explAIn-channel/bratan-robot/brain/ARCHITECTURE.md

> Журнал решений по ходу разработки (октябрь 2026). Где он расходится с кодом, прав код: например, связь с платой текстовая, навыки идут на 25 Гц, а нейросеть езды загружена, но колёсами не управляет.

# Братан 2 — архитектура

Новый проект вместо r284/r285 (06.10.2026, по указанию владельца: всё переписать
заново, качественно, максимально быстро; логика, данные и обученные модели — старые).
Старая версия остаётся на телефоне и плате для отката.

## Железо (измерено 06.10.2026)

| Узел | Факт | Вывод для архитектуры |
|---|---|---|
| Телефон SoC | Snapdragon 845: 4×A75 2,8 ГГц (cpu4-7) + 4×A55 1,77 ГГц (cpu0-3), 7,7 ГБ ОЗУ, 52 °C | тяжёлое на большие ядра, фон — на малые |
| Детектор YOLO26n-320 (ORT CPU) | 115 мс/1 поток, 70 мс/2, **50 мс/4 больших**, 134 мс/4 малых | 3 потока на cpu5-7: ~10 кадров/с |
| YOLO26n-640 / YOLOE-seg-640 | 183 / 292 мс на 4 больших | только для «рассмотреть», по запросу |
| Камера (id 1, фронт) | YUV 640×480, сенсор ≥15 кадр/с, **приложение режет до 4 кадр/с**, JPEG 45 КБ: выборка 9 мс + декод 6 мс | снять ограничение, отдавать свежий кадр сразу |
| Микрофон | 16 кГц моно, VOICE_RECOGNITION, NS+AEC | годится; поток вместо опроса |
| Плата | Allwinner A33 4×A7 1,2 ГГц, 512 МБ, почти простаивает | реальное время 50 Гц на плате |
| Связь телефон↔плата | Wi-Fi, RTT 3 мс, 50 Гц тело, пропуски до 0,1 с | ок; бинарный кадр вместо 1,2 КБ JSON |
| ИИ-мозг | OpenRouter deepseek-v4-flash: первый токен 0,9–1,5 с, ответ 1,2–2,6 с с keep-alive | одно постоянное соединение, короткие подсказки |
| GPT-Live | соединение 0,8 с через прокси, старт сессии ~1 с | соединение открывается в момент «Братан», параллельно с речью |
| Аккумулятор телефона | лимит 80 %, продолжение с 75 % (qcom restricted_charging) | сохранить |

## Процессы на телефоне

```
supervisor (bratan.main) ── шина (Unix-сокет, JSON-строки, pub/sub)
 ├─ body   cpu4, nice -10   связь с платой, поза, локализация, безопасность, навыки движения
 ├─ eyes   cpu5-7           камера, детектор, лица, трекер, геометрия
 ├─ voice  cpu0-1           микрофон, «Братан», GPT-Live, озвучка
 └─ mind   cpu2-3 (в supervisor)  жизнь, мозг (LLM), память, общение
```

Все процессы общаются только через шину. Тело не зависит от шины в вопросах
безопасности: защита от столкновений, сторож связи и остановка — внутри body.

## Ключевые решения по скорости

1. **Голос сразу в GPT-Live.** На «Братан» (первая ступень Vosk) сразу открывается
   сессия и в неё идёт звук с предзаписью; подтверждение имени (поток Vosk) идёт
   параллельно. Ответ GPT-Live проигрывается только после подтверждения; иначе
   сессия закрывается молча. Нет «конец речи → STT 1,2 с → соединение 2 с».
2. **Разговор — одно состояние.** Пока идёт живая сессия, мозг не управляет телом
   сам (только по просьбе человека) и не считает разговор оконченным.
3. **Мозг по событиям, без опроса раз в секунду.** События с шины сразу будят мозг;
   постоянное HTTPS-соединение к модели; подсказка ~2–3 тыс. токенов.
4. **Локализация на каждом скане.** Сопоставление скана с полем расстояний —
   Гаусс–Ньютон с аналитическим якобианом (≈2 мс), без процесса раз в 0,5 с.
5. **Управление 50 Гц, навыки 20 Гц** (было 10 Гц).
6. **Зрение без искусственных пауз.** Свежий кадр → детектор → событие на шине
   (≈100 мс от кадра до мозга вместо 0,4–2 с).

## Данные, переносимые из старой системы

карта квартиры и комнаты; поза базы и её эталонный скан; лица; альбом;
мысли/желания/планы/навыки/«кто я» мозга; характер; места; значимые предметы
(≥3 наблюдения); калибровки колёс, камеры, лидара; обученная нейросеть движения.

## Заученные проезды (07.10.2026, указание владельца)

Узкие двери, где поиск пути не справляется (кухня: Г-образный поворот с порогом, 8 см запаса на правильной линии), не ищутся, а проезжаются по линии, которую задал владелец, поставив робота руками (`body/passages.json`: старт x, y, курс; длина; скорость; отступ подхода; ворота-дверь). `Navigate` после каждого плана проверяет, проходит ли маршрут через ворота в направлении линии; если да — `passage_approach` (вложенный `Navigate` к точке на линии позади старта, без проездов), `passage_run` (0,24 м/с, курс линии минус 3 рад/м × боковое отклонение по позе карты, удержание курса платой), потом обычный план. Застрял 2,5 с — `passage_back`: задом по той же линии к началу и снова, до трёх раз; затем отказ `passage_blocked`, уже выехав из проёма.

## Мотивация (06.10.2026, по исследованию)

Владелец: «ничего не делать — странный выбор, у людей всегда есть мотивация». Анализ памяти мозга: целей, желаний, планов не было; будили только внешние события и таймер.

Источники и что взято:
- Kismet (Breazeal, MIT): потребность имеет комфортную зону — без дела уходит в «недостаток» (искать), при перегрузке в «избыток» (заняться другим). Взято: много разговоров за час — «скучаю по своим» утолено.
- Psi / MicroPsi (Dörner, Bach): самоистощающиеся потребности (энергия, принадлежность) и когнитивные (компетентность, определённость); подцели — части планов, ведущих к утолению. Взято: «уверенность» растёт от неудач тела и предлагает то, что точно получится.
- D2A (ICLR 2025, Wang и др.): у каждой потребности текущий и желаемый уровень (от характера), разрыв — мотив, уровни подаются модели словами; агент выбирает из кандидатов. Против ReAct/BabyAGI/LLMob 60–70 % побед по естественности и больше разнообразия. Взято: цели уровней от черт характера, словесные описания, кандидаты занятий у каждой потребности.
- Generative Agents (Park и др., 2023): поток памяти, рефлексия, план дня. Взято: рефлексия раз в 3 ч на базе («кто я», вывод), набросок своих планов, если их нет; сводка дня.
- Oudeyer (IAC): интересно новое, но достижимое. Взято: закрытые пути и непереведённые вещи не предлагаются.
- Anki Vector (открытый код): настроения Happy/Confident/Social затухают к дружелюбному «по умолчанию», «стимуляция» от людей/событий решает между исследованием и дремотой на зарядке; от чисто эмоционального поведения отказались в пользу явных переходов с кулдаунами. Взято: бодрость из недавних событий, настроение с добрым умолчанием, явные кулдауны (комната 10 мин, закрытый путь 10 мин), простой 2 мин → выбор занятия, ещё 2 мин → база.
- Sony aibo (патенты): независимые параметры желаний (упражнение, привязанность, аппетит, любопытство), обновляемые по времени и событиям, с взаимными корреляциями. LOVOT: потребность быть рядом с людьми как главный мотив.

Реализация: `bratan/mind/drives.py` (всё считается из архива и мира, переживает перезапуск), строки промпта «КАК Я СЕБЯ ЧУВСТВУЮ», «МОИ ПОТРЕБНОСТИ СЕЙЧАС», «МОИ ДОЛГИЕ ЦЕЛИ».

## Живость (07.10.2026, аудит по живым данным и мировому опыту)

Что делает робота живым, а не «умной колонкой» (Takayama/Ju HRI 2011, Vector, aibo, LOVOT, Miksik 2020):
- **Тело выражает внимание сразу, без модели.** Лицо и лампа: «слушаю» синий, «думаю» фиолетовый, «говорю»
  зелёный (голос, `source=voice`); мгновенные реакции на события (`source=reaction`): Таффа — радость, удар —
  удивление, перенос руками — удивление, касание кнопки — нежность. Глаза смотрят на человека (лицо первым) или
  Таффу по пеленгу камеры, в движении — в сторону поворота (`/gaze`, x>0 — влево от робота).
- **Привычки и привязанность считаются кодом**, модель только читает итог: где и когда кто бывает
  (по наблюдениям за 2 недели, время появления после перерыва), близость по разговорам и встречам (aibo/LOVOT:
  к тем, кто общается, робот привязывается сильнее). Это даёт поводы: «Сергей вечером обычно в спальне»,
  «Таффа чаще в коридоре» — и поиск идёт туда, а не вращением на месте.
- **Память честная и текущая.** Предмет, на место которого робот смотрит при свете и не видит, теряет доверие и
  забывается; посещения и освещённость комнат переживают перезапуск; планы имеют время и срок, желания — срок.
- **Речь редкая и по поводу.** Свои действия вслух не объявляются; мысли вслух — не чаще раза в 10 мин;
  одно приветствие Таффе за 20 мин; «помолчи» — инструмент `hush` на N минут; отказанная реплика не будит ум.
- **События устойчивы.** «Пришёл/ушёл» — после 2 кадров; потеря места — после 3 с; база — после 2 с без дребезга.

## Чувства и выражение (08.10.2026, второй аудит)

- **Слух** (`voice/sounds.py`, YAMNet 18 мс): лай, звонок, стук, хлопок двери, музыка, смех, плач, грохот и др.;
  испуг от резкого звука; привыкание; свой голос не слушает. Ум знает только то, что в «Слышу».
- **Двери** (`body/doors.py`): лидар видит проём — лучи вглубь соседней комнаты значит открыта, в полосу проёма значит
  закрыта; ум знает достижимые комнаты.
- **Движение вокруг** (`body/motion.py`): стоя, лидар замечает шаги сбоку и сзади — робот оборачивается.
- **Язык тела людей** (`eyes/gesture.py`): YOLO26n-pose (93 мс, до 5 раз/с, пока человек в кадре, камера тогда
  6 кадров/с — «внимательный» режим): помахали — радость, «привет», виляние; обе руки вверх — дрожь радости.
  FER+ (105 мс, раз в секунду, лицо от 56 пикселей): улыбка — улыбка в ответ молча; грустное лицо — ум может
  один раз мягко спросить. Топик `eyes.gesture {kind: wave|hands_up|smile|sad|surprise, who}`.
- **Выражение чувства целиком** (`life.express`): тело (`skills.Emote`: виляние, дрожь вперёд-назад, подпрыгивание,
  кивок, «нет», кружок, поклон — цели по одометрии), звук без слов как у R2-D2 (`voice/sfx.py`, уровень 0,032)
  и подсветка. Подсветка — LED-панель ELK-BLEDDM по BLE из приложения-лица: спокойное ожидание — ровный тёплый
  свет; чувство — встроенный режим панели на несколько секунд (`POST /mood-light/effect?name=&seconds=`, лицо 87+):
  rainbow (переливы 7 цветов), party (прыжки цветов), flash (белое мигание), warm/love/curious/calm (дыхание
  жёлтым/малиновым/голубым/синим), no (красное дыхание). Камера подтверждает мигание (разброс яркости кадров ×10).
- **Звуки** — редко и только для людей: вне базы, с человеком рядом, в игре или по просьбе; на базе — молча
  (владелец 08.10); никогда в одиночестве, никогда о внутреннем состоянии; одна пауза 30 с на рефлексы и ум.
- **Лицо в простое** — одно спокойное ожидание (моргает); чувства — только на настоящие события
  (`FACE_TRIGGERS`), коротким слоем reaction.
- **Встреча**: свой после 3+ часов разлуки — ум получает «ВСТРЕЧА» и дневник дома за это время
  (звонки, двери, Таффа, игры) и может одной фразой рассказать главное.
