explAIn-channel/bratan-robot/docs/media/consciousness.jpg

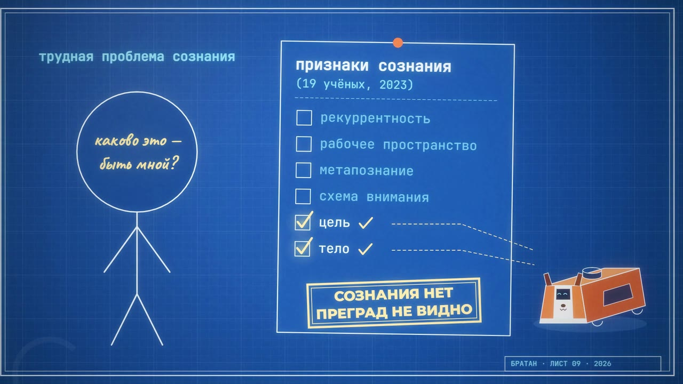
docs/media/consciousness.jpg
