explAIn-channel/bratan-robot/docs/media/face_close.jpg

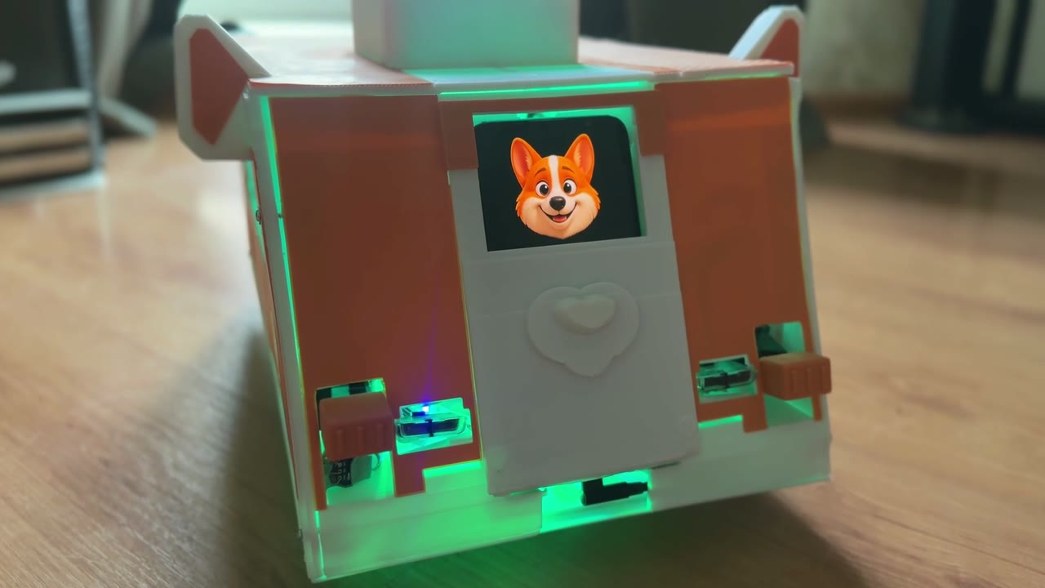
docs/media/face_close.jpg
