explAIn-channel/bratan-robot/docs/media/robot_eyes.jpg

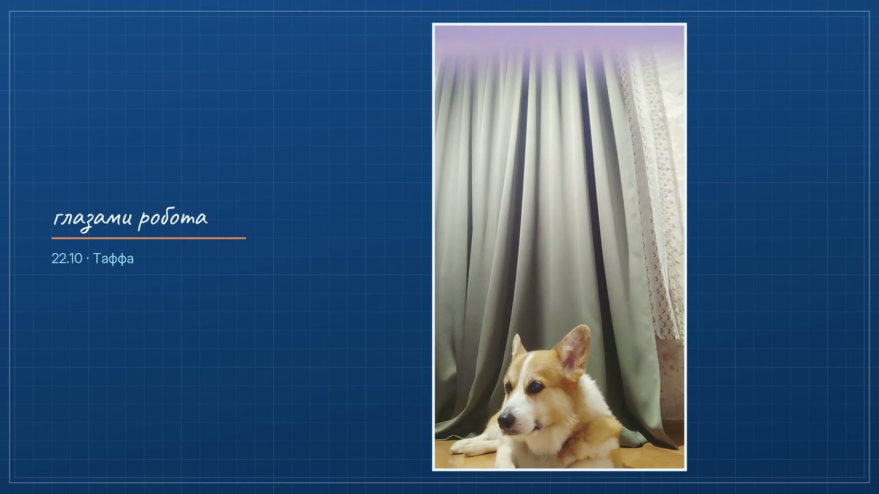
docs/media/robot_eyes.jpg
