explAIn-channel/bratan-robot/docs/media/two_brains.jpg

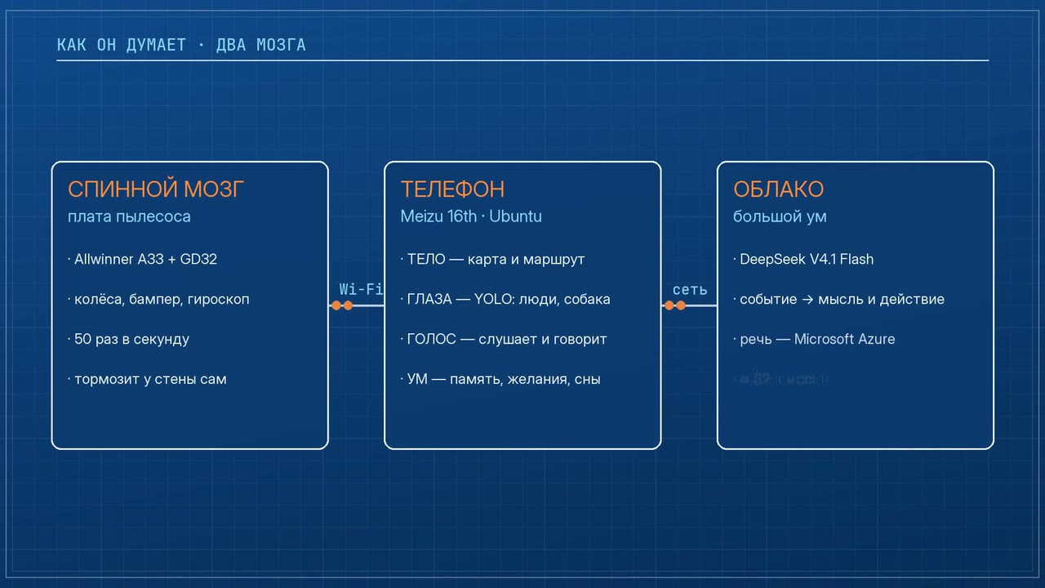
docs/media/two_brains.jpg
