explAIn-channel/bratan-robot/docs/media/weather.jpg

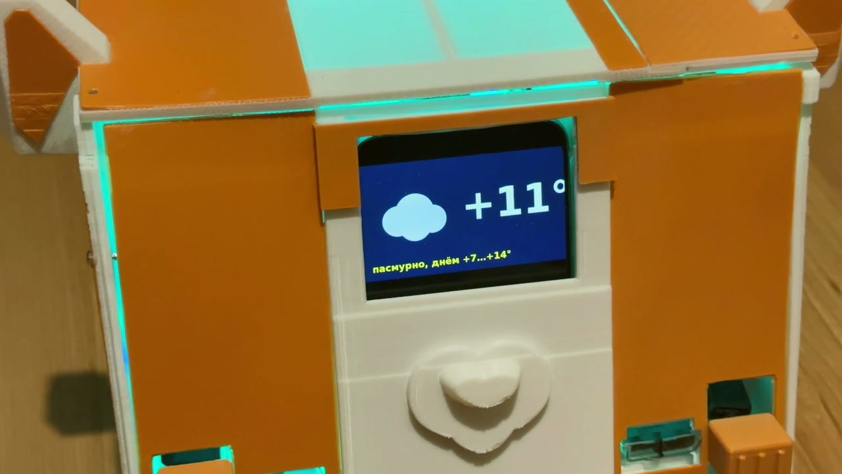
docs/media/weather.jpg
