explAIn-channel/bratan-robot/docs/media/why_vacuum.jpg

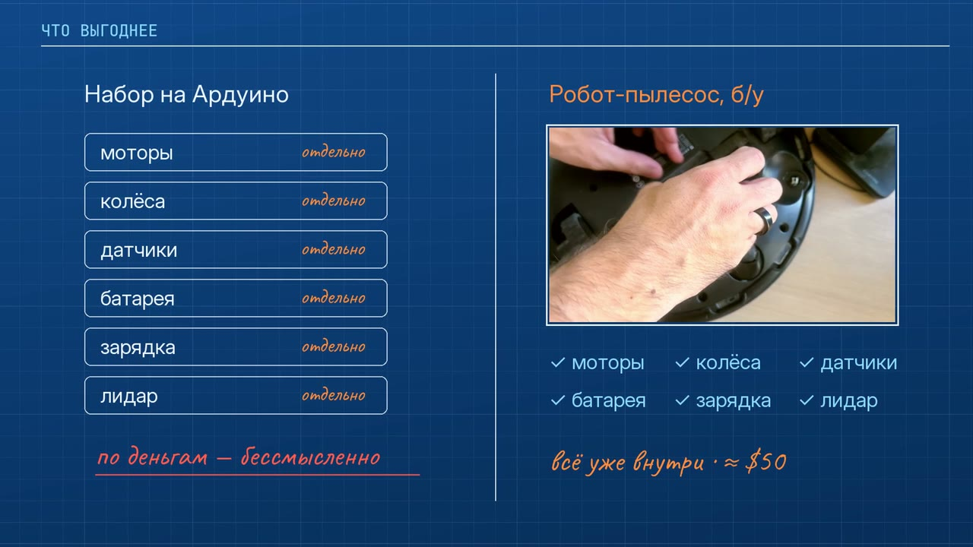
docs/media/why_vacuum.jpg
