explAIn-channel/bratan-robot/docs/media/with_taffy.jpg

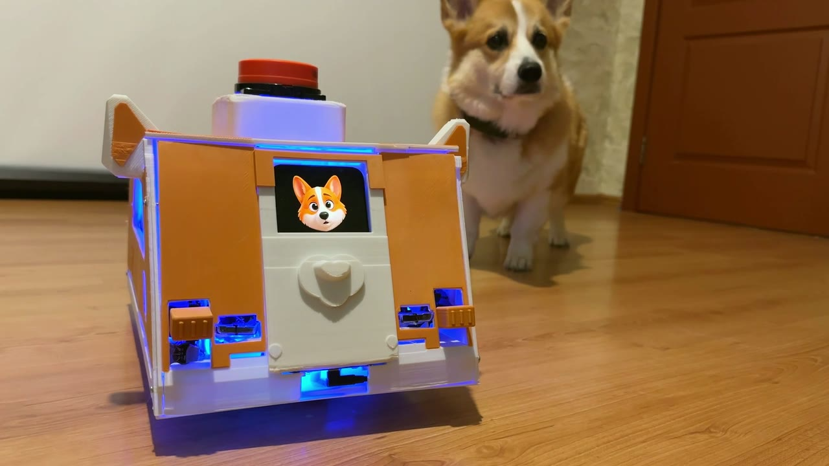
docs/media/with_taffy.jpg
