explAIn-channel/bratan-robot/docs/media/cost.jpg

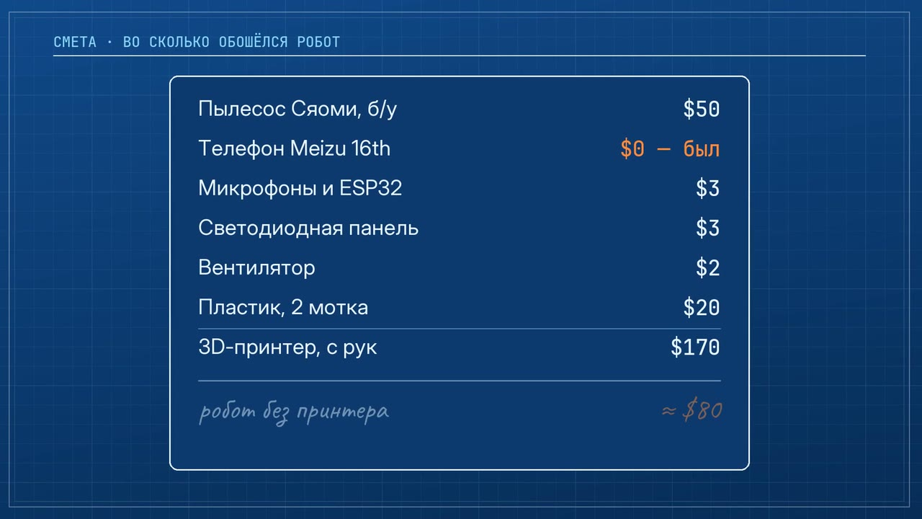
docs/media/cost.jpg
