explAIn-channel/bratan-robot/body/print/orange/08_roof_main_orange_inlay.stl

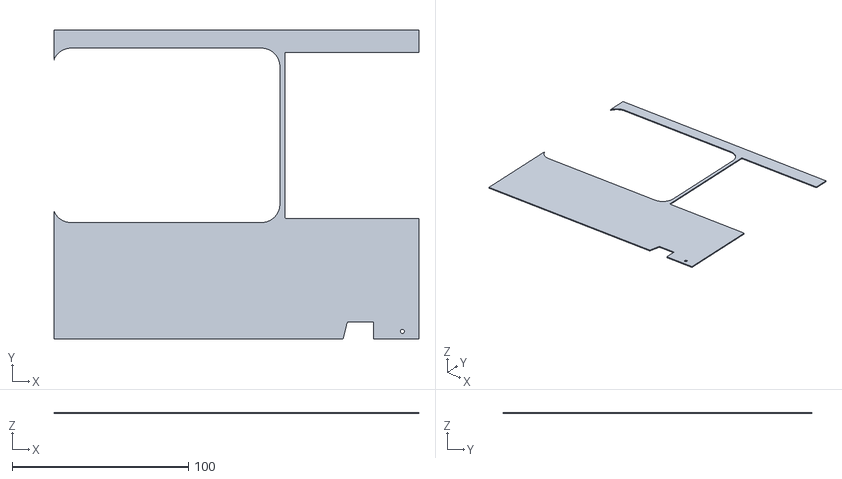
[picture p27: CAD file, 2026-10-23]
body/print/orange/08_roof_main_orange_inlay.stl
207.2 x 175.1 x 0.8
