explAIn-channel/bratan-robot/body/print/white/11_lid_front_main.stl

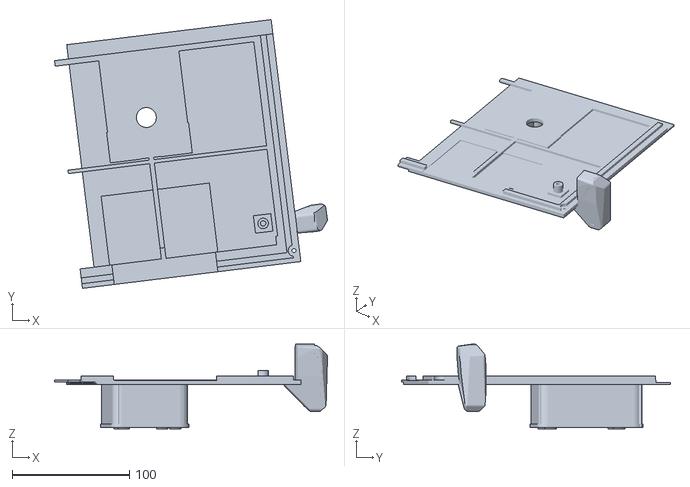
[picture p28: CAD file, 2026-10-23]
body/print/white/11_lid_front_main.stl
233.3 x 229.6 x 72.5
