explAIn-channel/bratan-robot/body/bratan_body_r5.stl

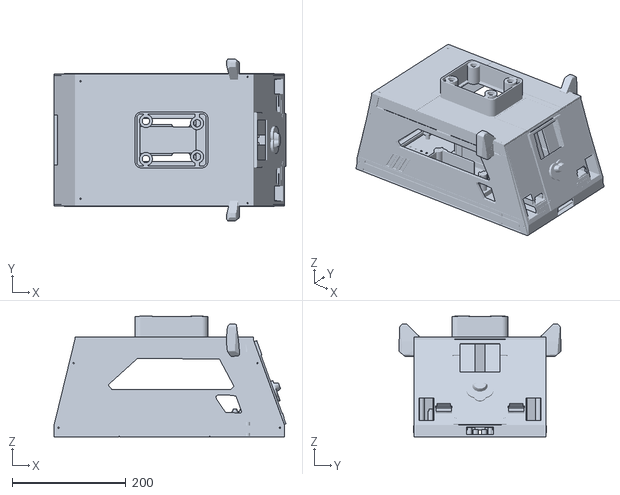
[picture p29: CAD file, 2026-10-23]
body/bratan_body_r5.stl
408.6 x 285.9 x 213.1
