explAIn-channel/bratan-robot/body/print/orange/09_roof_side_orange_inlay.stl

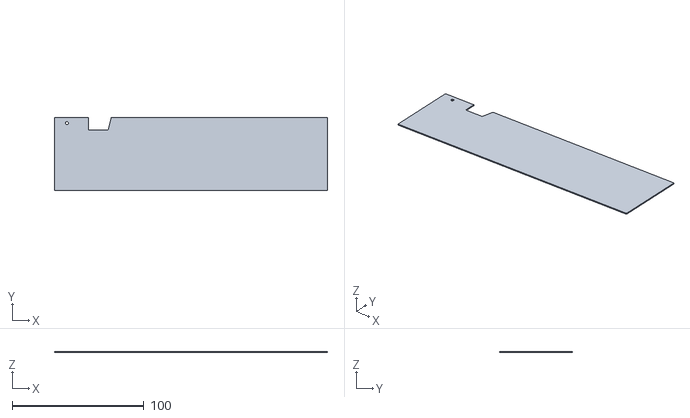
[picture p30: CAD file, 2026-10-23]
body/print/orange/09_roof_side_orange_inlay.stl
207.2 x 55.1 x 0.8
