explAIn-channel/bratan-robot/body/print/white/13_lidar_carrier.stl

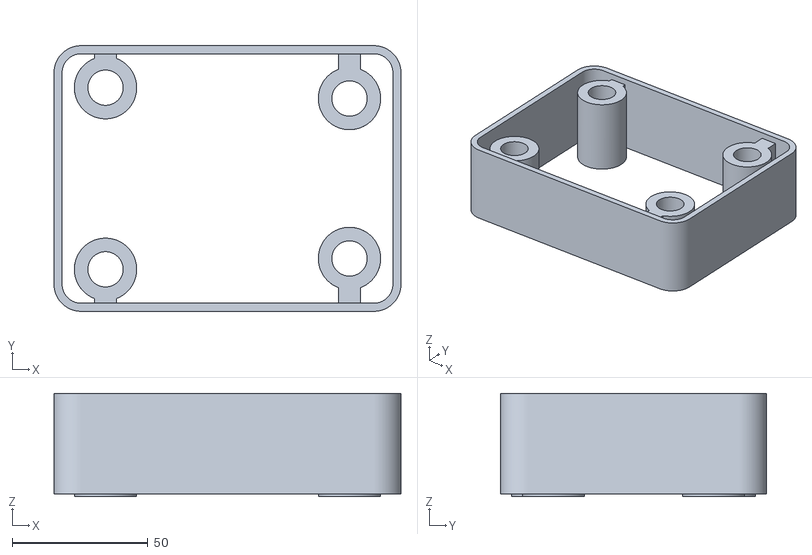
[picture p31: CAD file, 2026-10-23]
body/print/white/13_lidar_carrier.stl
128.0 x 98.0 x 38.0
