explAIn-channel/bratan-robot/body/print/orange/12_lid_rear_orange_inlay.stl

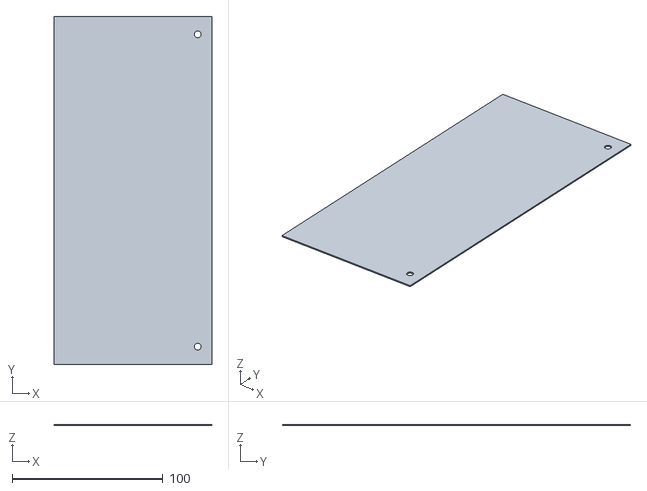
[picture p32: CAD file, 2026-10-23]
body/print/orange/12_lid_rear_orange_inlay.stl
104.7 x 230.9 x 0.8
