explAIn-channel/bratan-robot/body/print/white/12_lid_front_side.stl

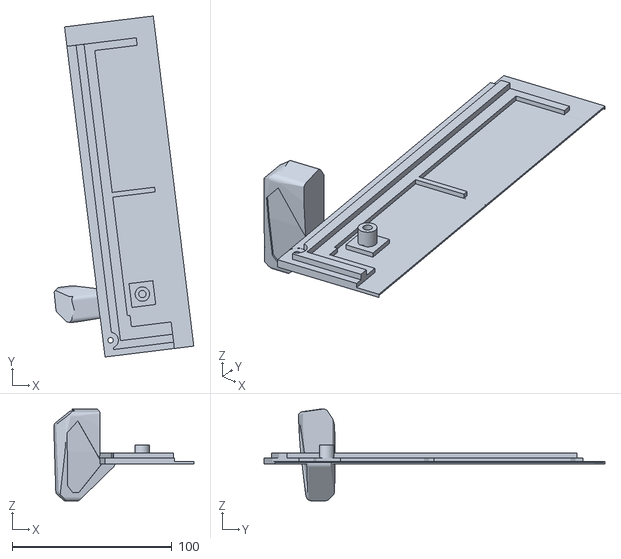
[picture p33: CAD file, 2026-10-23]
body/print/white/12_lid_front_side.stl
87.4 x 213.5 x 57.5
