explAIn-channel/bratan-robot/body/print/orange/10_left_ear_orange_inlay.stl

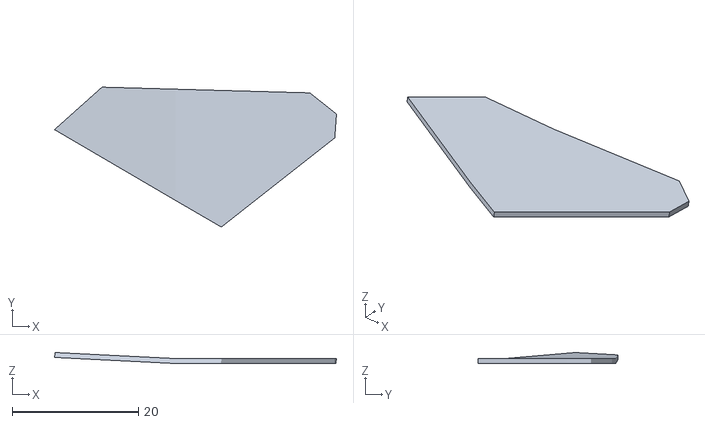
[picture p34: CAD file, 2026-10-23]
body/print/orange/10_left_ear_orange_inlay.stl
44.7 x 22.2 x 1.74
