explAIn-channel/bratan-robot/body/print/white/03_floor_front.stl

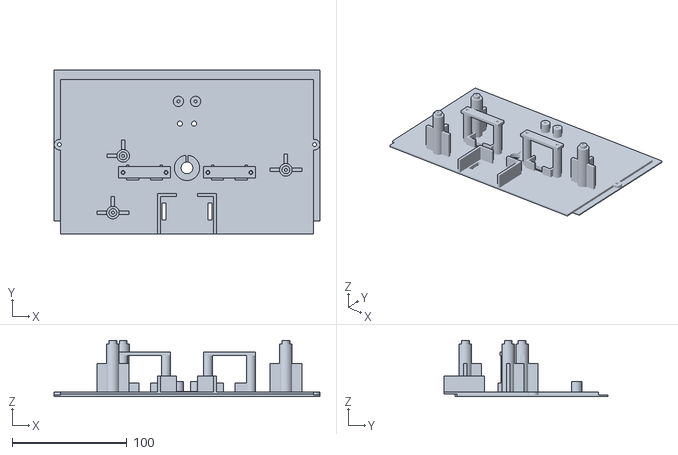
[picture p35: CAD file, 2026-10-23]
body/print/white/03_floor_front.stl
232.0 x 142.9 x 49.0
