explAIn-channel/bratan-robot/body/print/orange/01_left_rear_orange_inlay.stl

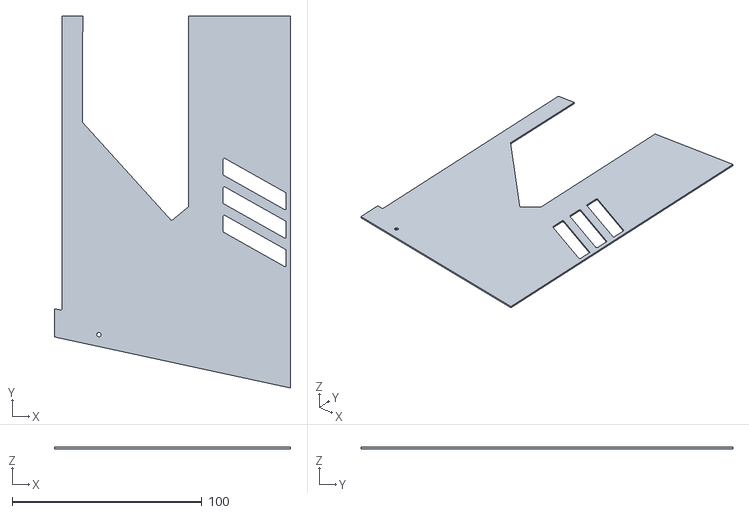
[picture p36: CAD file, 2026-10-23]
body/print/orange/01_left_rear_orange_inlay.stl
124.4 x 195.9 x 0.8
