explAIn-channel/bratan-robot/body/print/white/04_wall_left_rear.stl

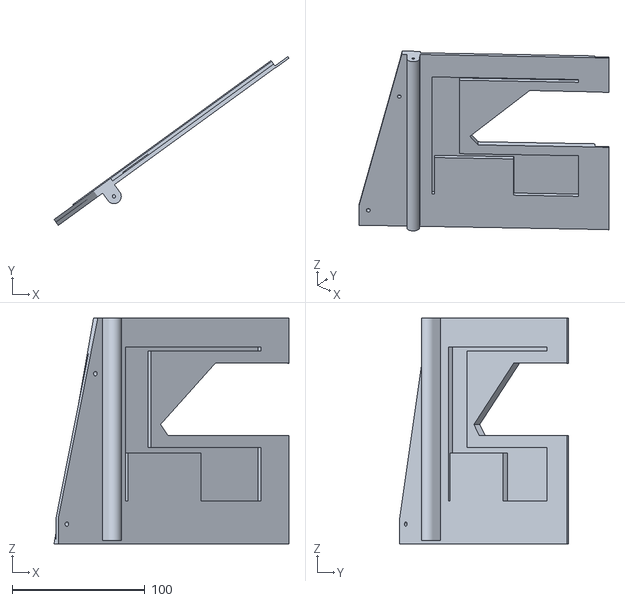
[picture p37: CAD file, 2026-10-23]
body/print/white/04_wall_left_rear.stl
177.3 x 127.4 x 170.5
