explAIn-channel/bratan-robot/body/print/orange/07_rear_orange_inlay.stl

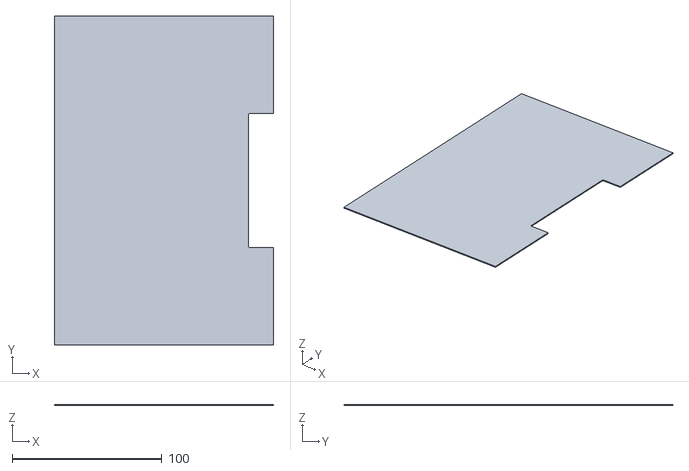
[picture p38: CAD file, 2026-10-23]
body/print/orange/07_rear_orange_inlay.stl
146.6 x 219.9 x 0.8
