explAIn-channel/bratan-robot/body/print/white/05_wall_left_front.stl

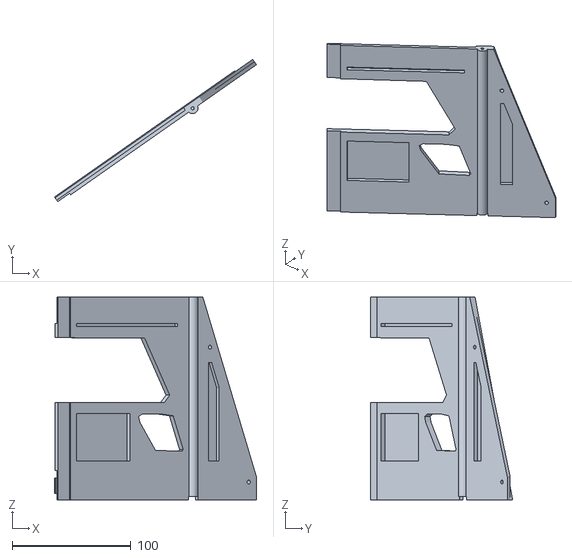
[picture p39: CAD file, 2026-10-23]
body/print/white/05_wall_left_front.stl
169.9 x 119.7 x 170.5
