explAIn-channel/bratan-robot/body/print/orange/02_left_front_orange_inlay.stl

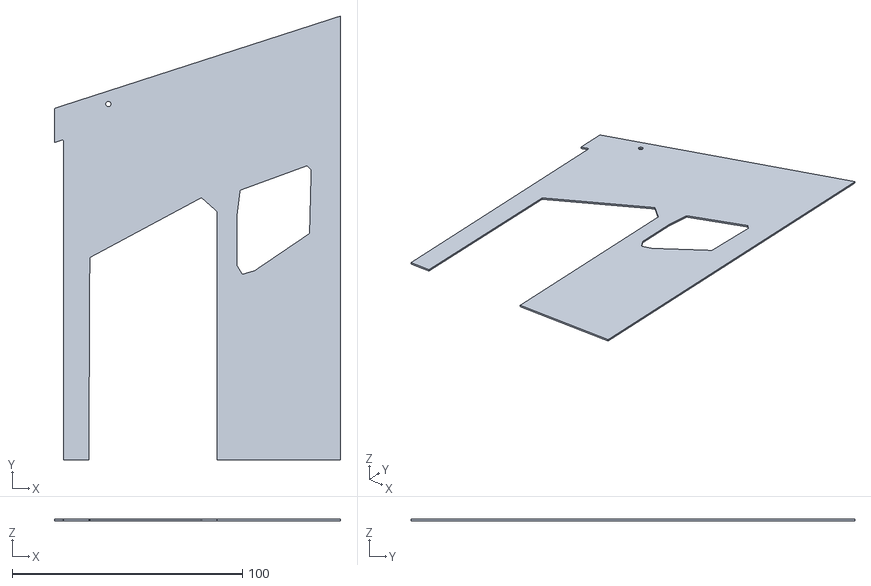
[picture p40: CAD file, 2026-10-23]
body/print/orange/02_left_front_orange_inlay.stl
124.4 x 193.0 x 0.8
