explAIn-channel/bratan-robot/body/print/white/10_lid_rear.stl

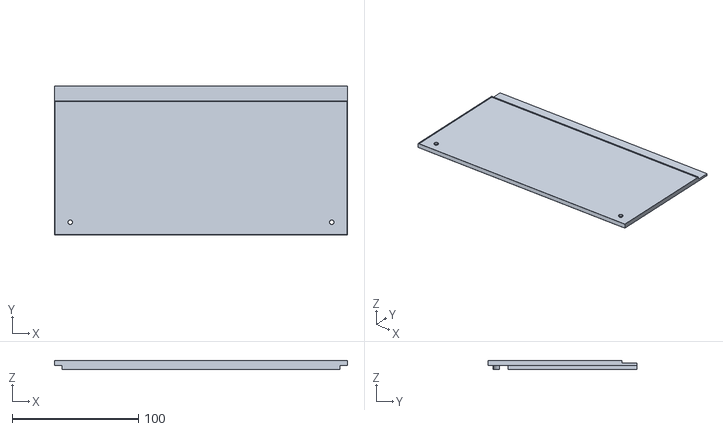
[picture p41: CAD file, 2026-10-23]
body/print/white/10_lid_rear.stl
232.0 x 117.8 x 7.00
