explAIn-channel/bratan-robot/body/print/orange/05_front_left_cover.stl

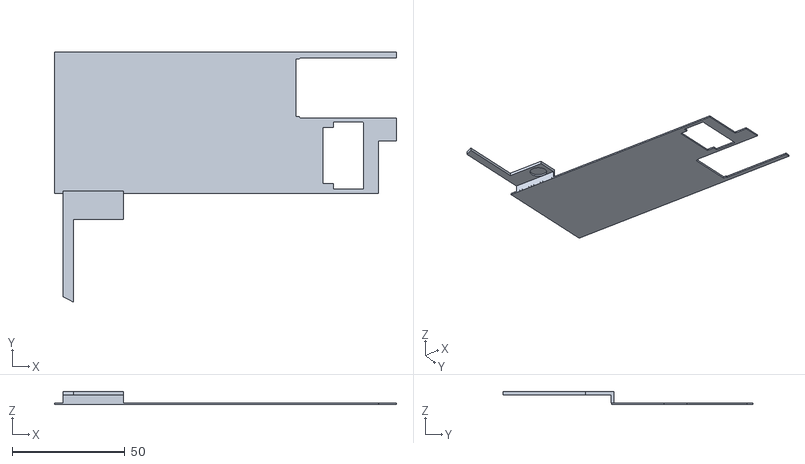
[picture p42: CAD file, 2026-10-23]
body/print/orange/05_front_left_cover.stl
151.8 x 111.2 x 5.85
