explAIn-channel/bratan-robot/body/print/white/01_floor_rear_back.stl

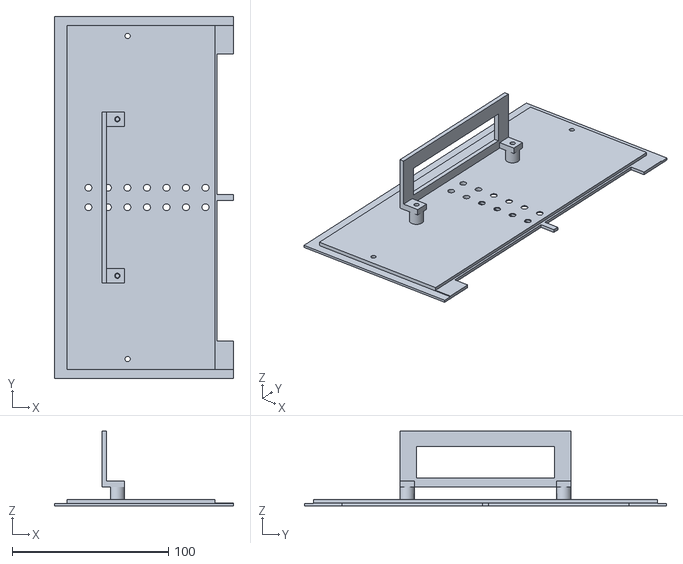
[picture p43: CAD file, 2026-10-23]
body/print/white/01_floor_rear_back.stl
114.7 x 232.0 x 47.9
