explAIn-channel/bratan-robot/body/print/white/09_wall_rear.stl

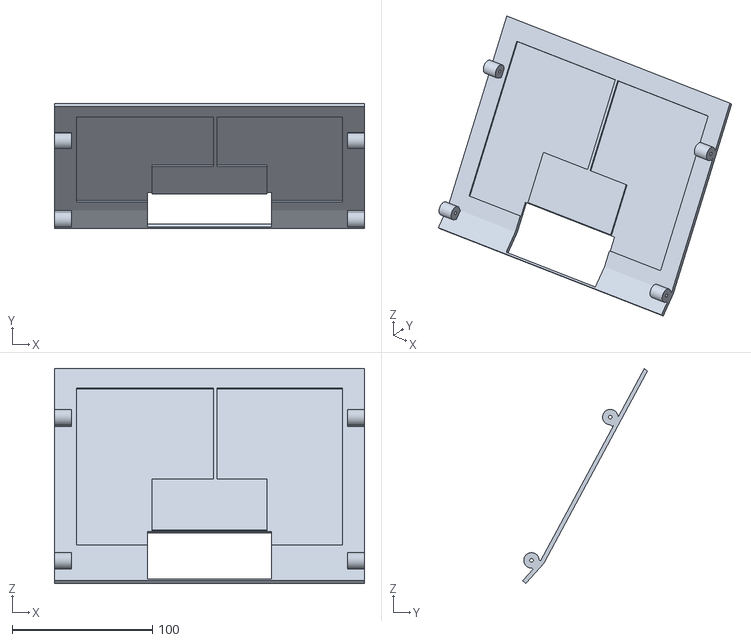
[picture p44: CAD file, 2026-10-23]
body/print/white/09_wall_rear.stl
221.0 x 88.9 x 153.3
