explAIn-channel/bratan-robot/body/print/white/02_floor_rear_middle.stl

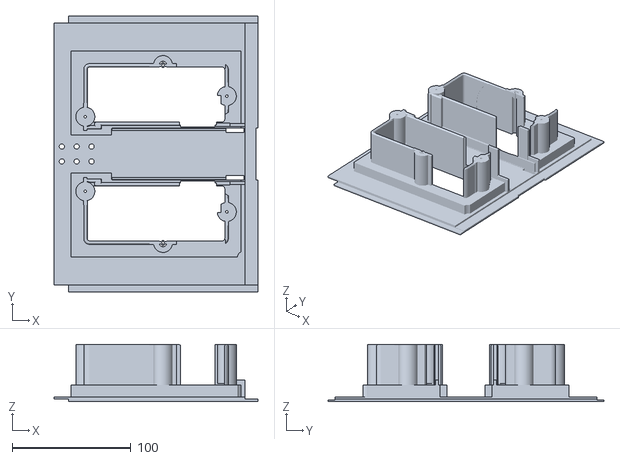
[picture p45: CAD file, 2026-10-23]
body/print/white/02_floor_rear_middle.stl
171.4 x 232.0 x 48.0
