explAIn-channel/bratan-robot/body/print/white/08_wall_front.stl

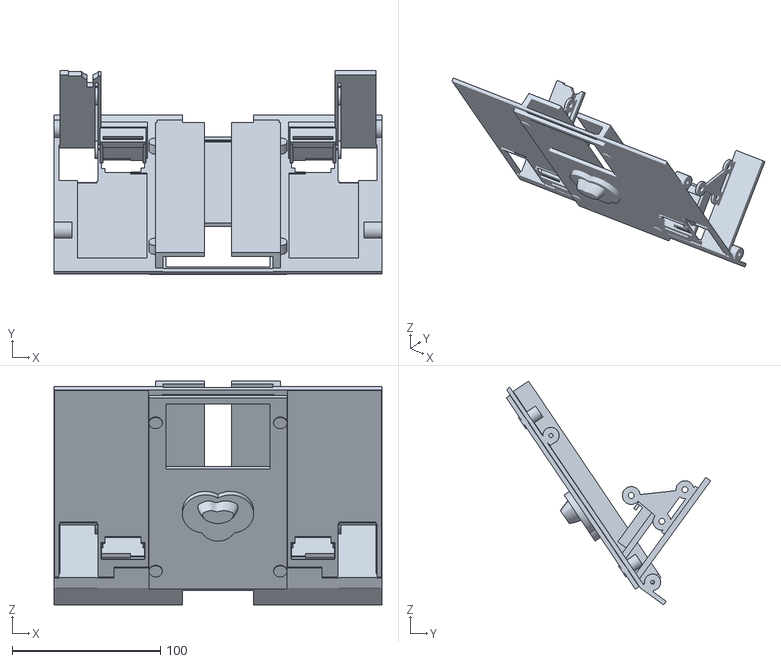
[picture p46: CAD file, 2026-10-23]
body/print/white/08_wall_front.stl
221.0 x 137.7 x 150.8
