explAIn-channel/bratan-robot/(list of files, cad)

Other CAD files:
body/print/white/07_wall_right_front.stl
body/print/orange/06_front_right_cover.stl
body/print/orange/03_right_rear_orange_inlay.stl
body/print/orange/11_right_ear_orange_inlay.stl
body/print/orange/04_right_front_orange_inlay.stl
body/print/white/06_wall_right_rear.stl
