explAIn-channel/bratan-robot/docs/media/diary.jpg

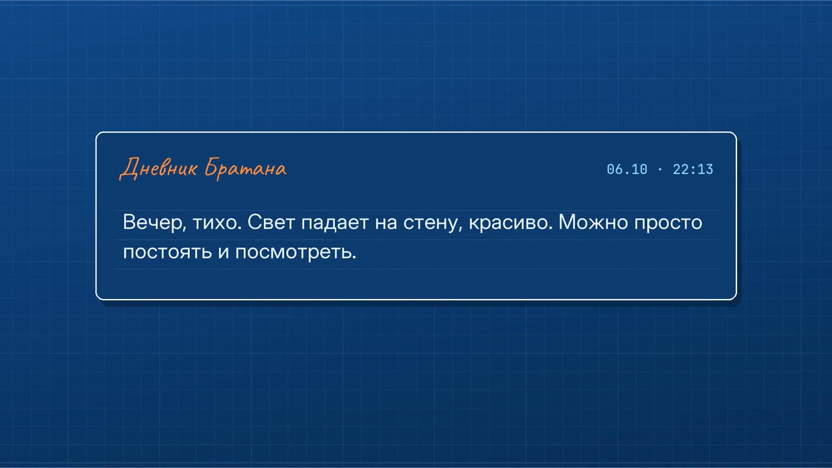
docs/media/diary.jpg
