explAIn-channel/bratan-robot/ears/tools/layout_front.py

"""16.10, владелец: «а почему один не поставить спереди под телефоном? там дырка есть; разговаривают там, где экран».
Сравнение: М1 спереди по центру под окном телефона против М1 в боковом вырезе спереди слева.
python tools/layout_front.py"""
import sys
from pathlib import Path

sys.path.insert(0, str(Path(__file__).parent))
import layout_sim as L  # noqa: E402

L.report({
    'без сверления 1: вырез спереди слева + прорези обоих боков': [(125, L.Y1), (-84, L.Y0), (-84, L.Y1)],
    'под телефоном: перёд по центру + прорези обоих боков': [(L.X1, 0), (-84, L.Y0), (-84, L.Y1)],
    'под телефоном + вырез спереди слева + прорези справа': [(L.X1, 0), (125, L.Y1), (-84, L.Y0)],
})
