explAIn-channel/bratan-robot/(commit log)

2026-10-23 Bratan: a home robot from a robot vacuum, a phone and a 3D-printed body
    Vacuum-board program (C), phone brain (Python), ESP32 microphone array,
    Android face app, printable R5 body and the driving-policy training kit.
    [01_floor_rear_back.stl, 01_left_rear_orange_inlay.stl, 02_floor_rear_middle.stl, 02_left_front_orange_inlay.stl, 03_floor_front.stl, 03_right_rear_orange_inlay.stl, 04_right_front_orange_inlay.stl, 04_wall_left_rear.stl]
2026-10-23 README in English with a big switch to the Russian version
2026-10-23 3D model section with the print and assembly animation
