explAIn-channel/bratan-robot/(notices)

Notices in the files:
README.md:
License: MIT
